Nihal786007/Apex/docs/Project_Roadmap.md

# APEX Project Roadmap

## Phase 1 ✅
- ESP32 Setup
- TB6612FNG Setup
- Motor Movement Test
- GitHub Repository

## Phase 2 🚧
- Professional Firmware Structure
- Bluetooth Control
- OLED Display
- Ultrasonic Sensor

## Phase 3
- Line Following
- Autonomous Navigation

## Phase 4
- AI Vision
- Voice Assistant

---

## Current evidence update — 27 October 2026

The phases above are the original roadmap and remain as historical context. V5 now implements manual Wi-Fi control, line following and bounded obstacle avoidance in software; its recorded build and tests are in [BUILD_REPORT.md](BUILD_REPORT.md). Supplied footage documents earlier manual-build work. Physical V5 line-following and autonomous-course acceptance remain pending. Bluetooth, vision and voice entries above are aspirations, not implemented-feature claims. The current [evidence-based roadmap](LIMITATIONS_AND_ROADMAP.md) governs new claims.
