Nihal786007/Apex/progress/Session_01_ESP32_First_Blink/Session_01_Notes.md

# Engineering Notes

## Date
16 July 2026

## Session
01

## Project
ESP32 First Blink

## Time Spent
(Write how many hours)

## Problems Faced

- Driver not detected initially.
- Windows showed Code 28.
- Installed CP210x driver manually.

## Solution

Installed the Silicon Labs CP210x driver and selected the correct COM port.

## Final Status

Project completed successfully.

## What I Learned Today

- How serial drivers work.
- How Arduino uploads code.
- How COM ports are assigned.
- How to troubleshoot ESP32 connection issues.

## Confidence Level

⭐⭐⭐⭐☆
