Nihal786007/Apex/assets/dashboard-line-preview.png

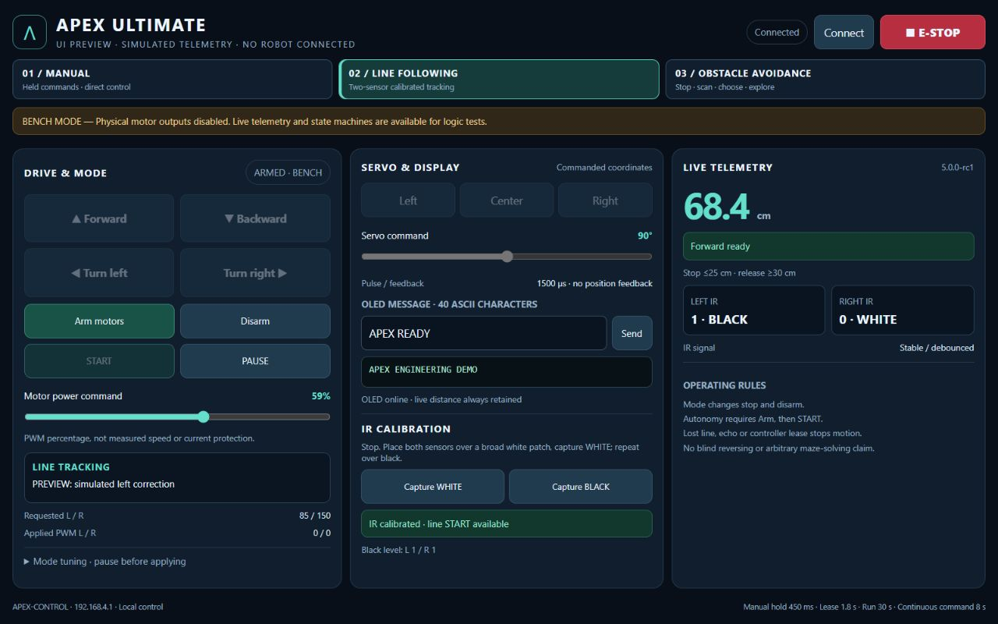
assets/dashboard-line-preview.png
