Nihal786007/Apex/assets/dashboard-phone-preview.png

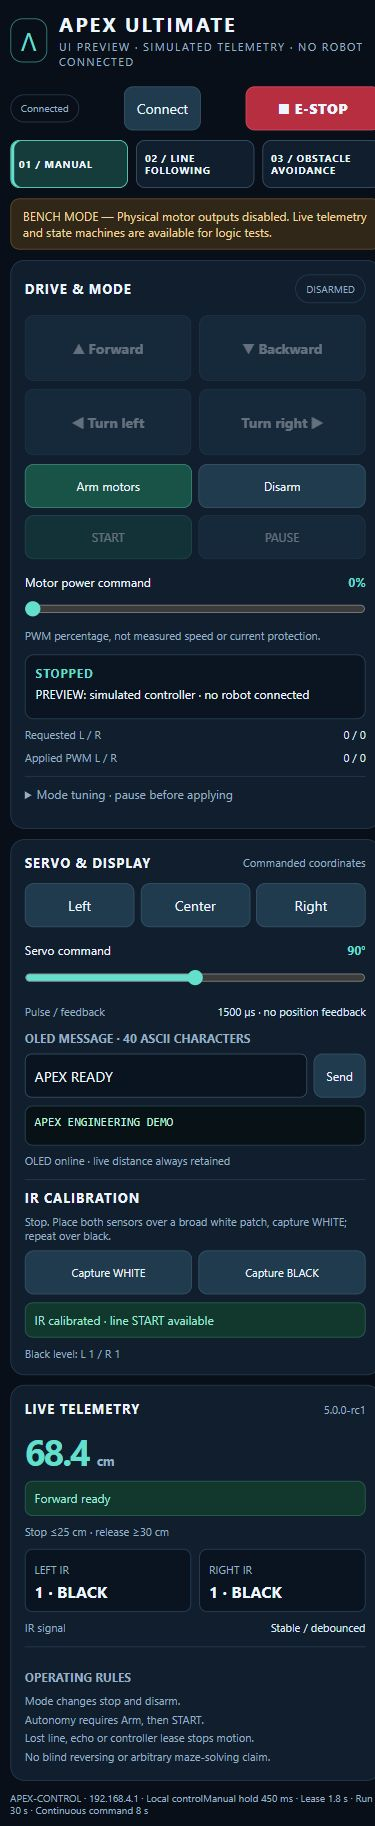
assets/dashboard-phone-preview.png
