Nihal786007/Apex/assets/photos/connecting ESP32.jpeg

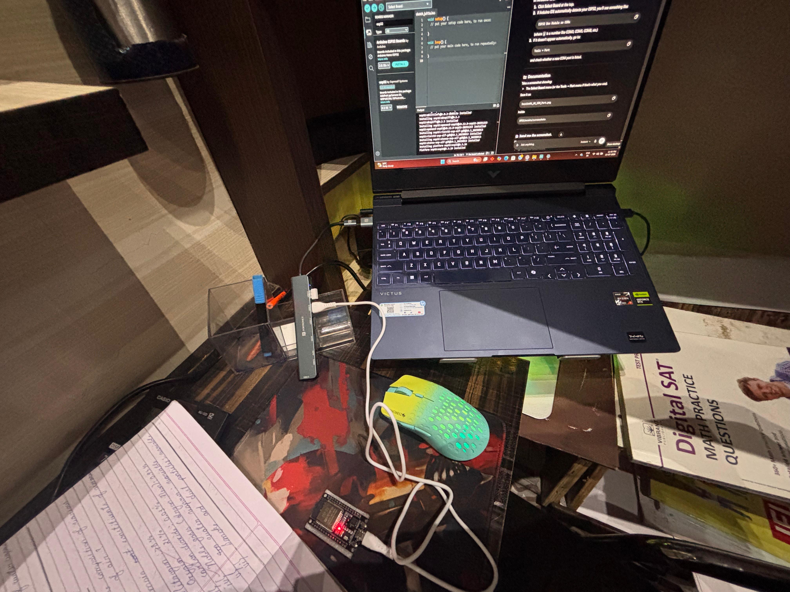
assets/photos/connecting ESP32.jpeg
