Nihal786007/Apex/assets/photos/esp32.jpeg

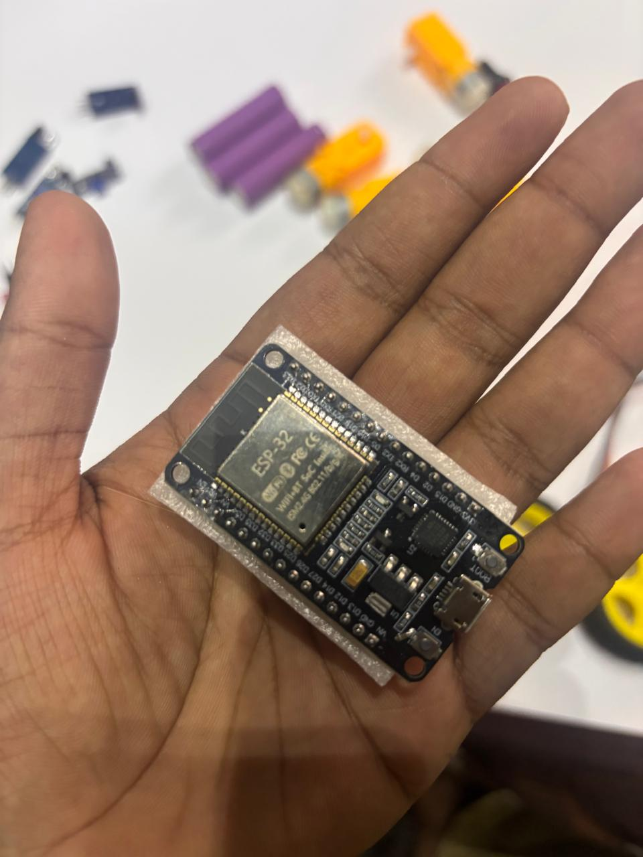
assets/photos/esp32.jpeg
