Nihal786007/Apex/assets/screenshots/connecting com .png

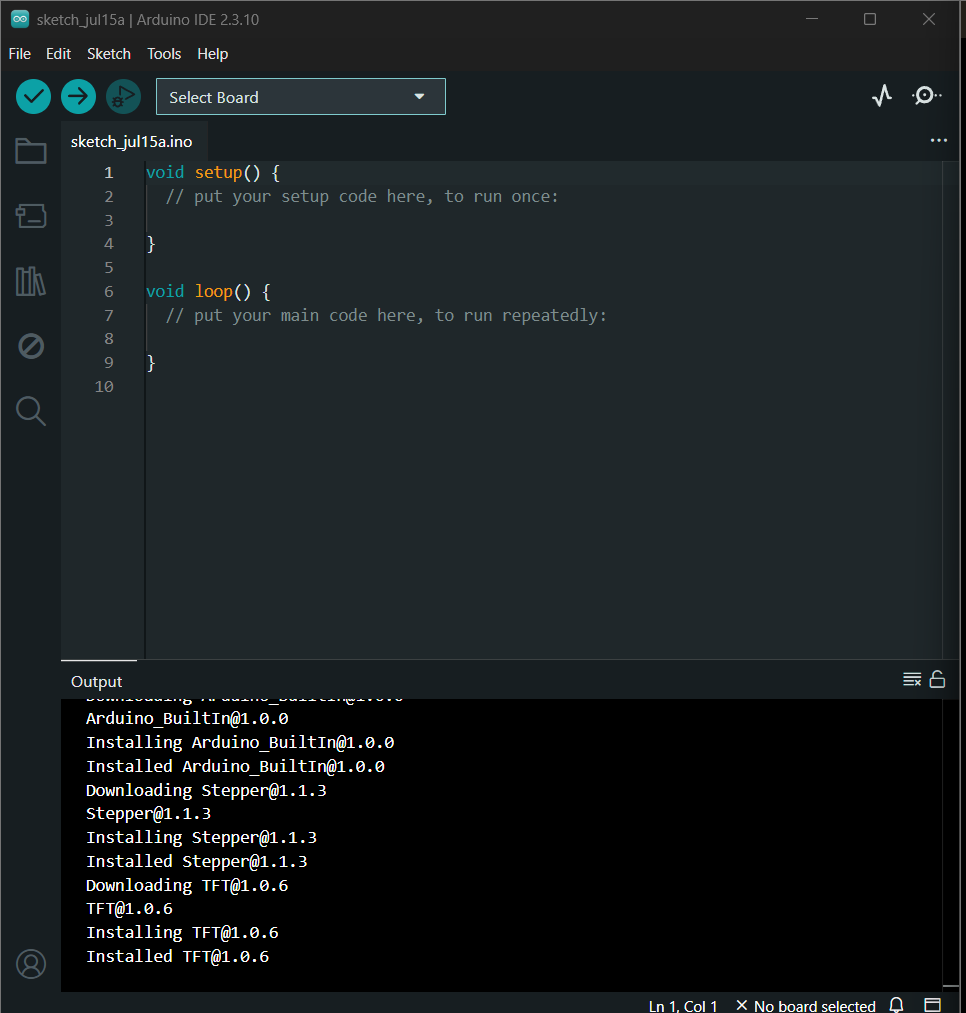
assets/screenshots/connecting com .png
