Nihal786007/Apex/assets/screenshots/python code for blinking esp32.png

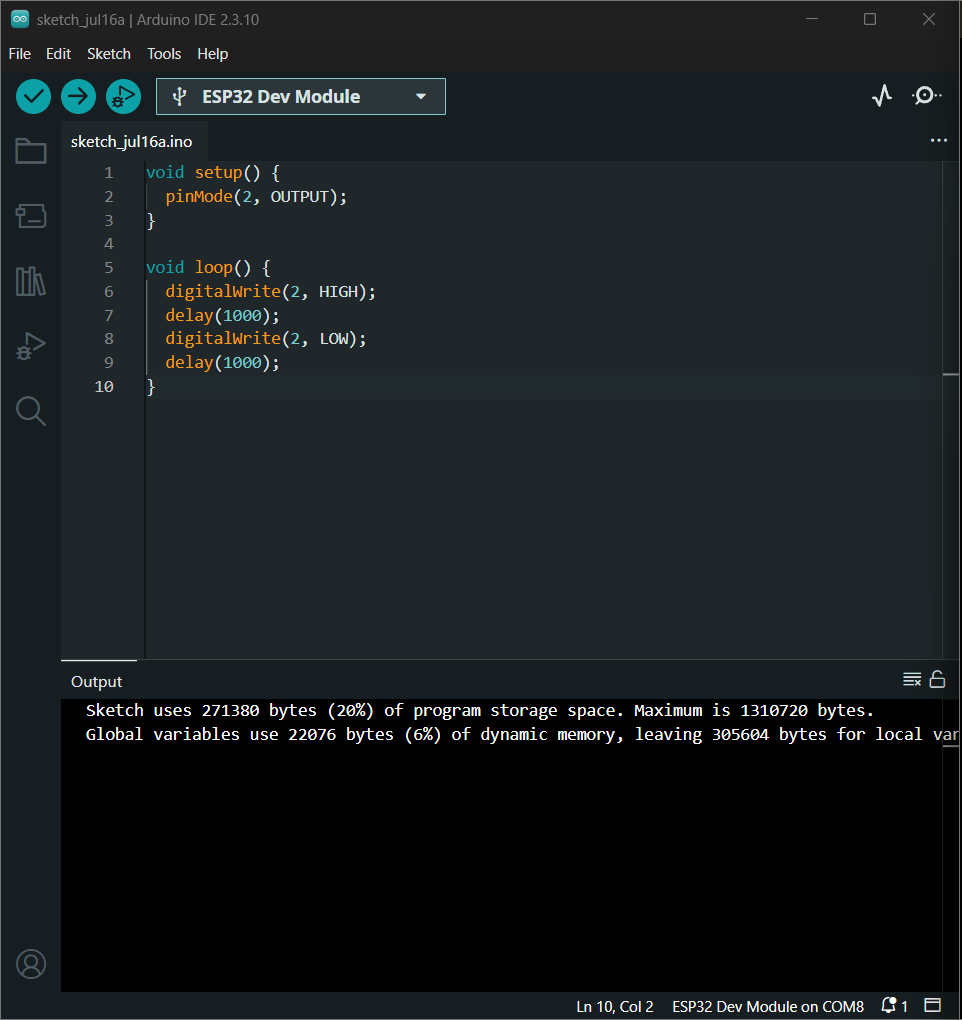
assets/screenshots/python code for blinking esp32.png
