Nihal786007/Apex/assets/screenshots/Screenshot (143).png

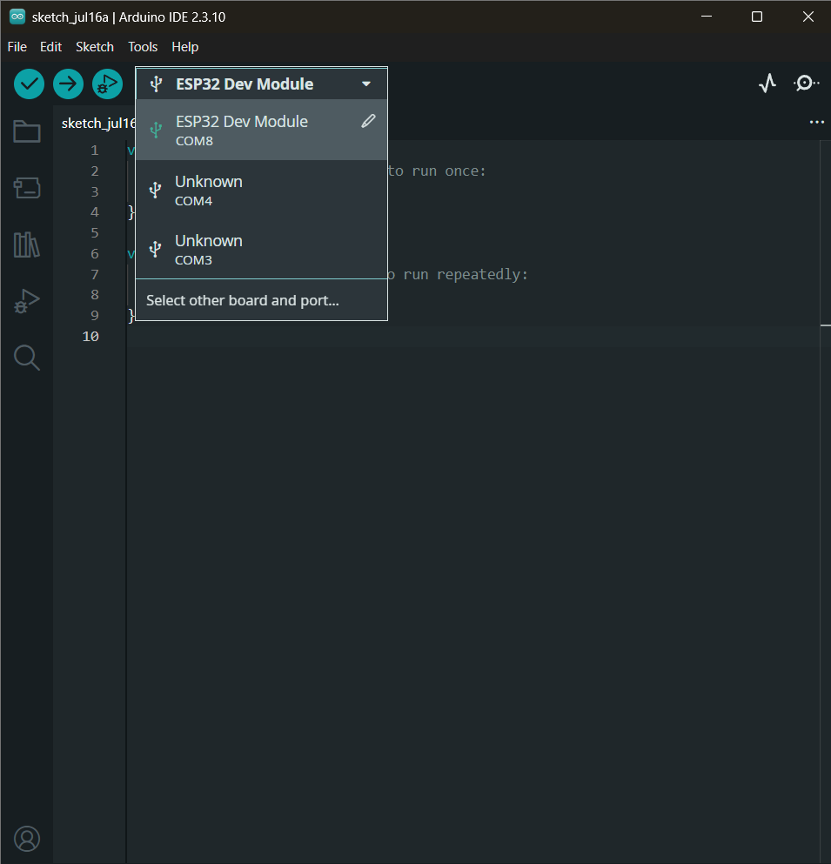
assets/screenshots/Screenshot (143).png
