Nihal786007/Apex/assets/screenshots/Session01_02_ESP32_Search.png

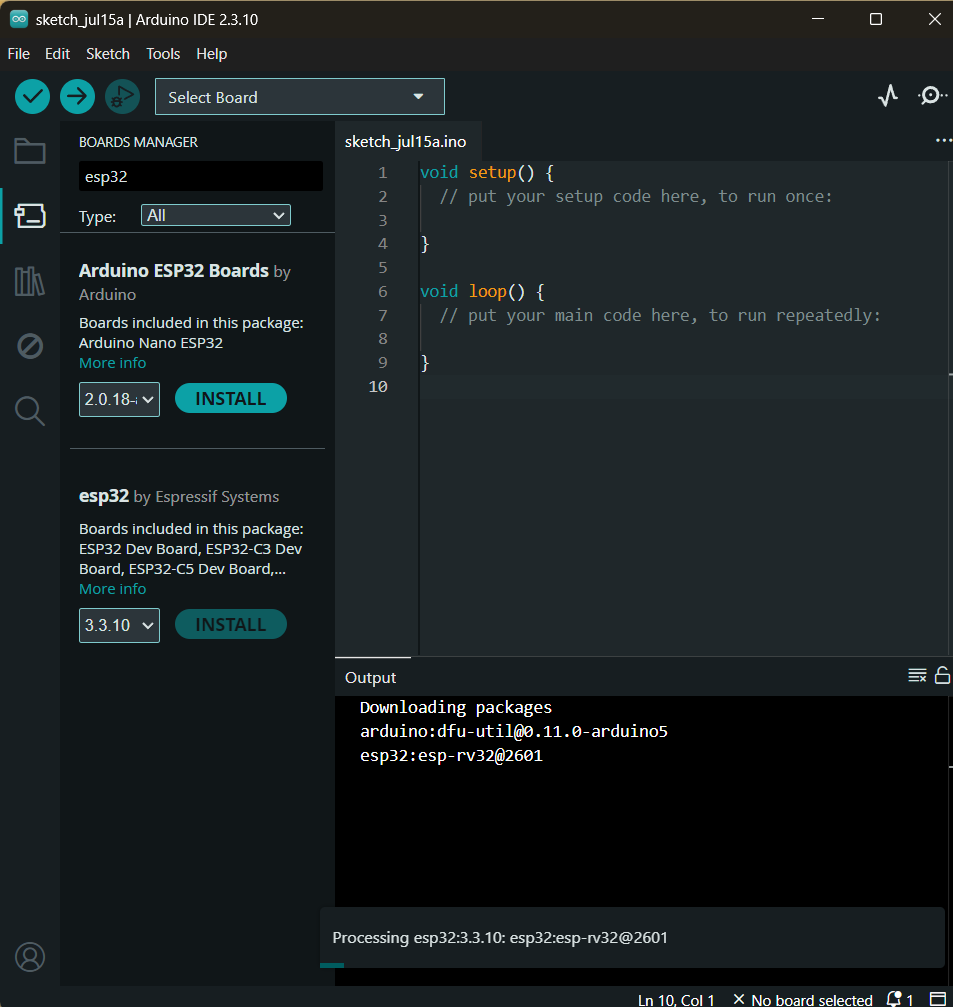
assets/screenshots/Session01_02_ESP32_Search.png
