Nihal786007/Apex/assets/screenshots/Session01_04_ESP32_Installed.png

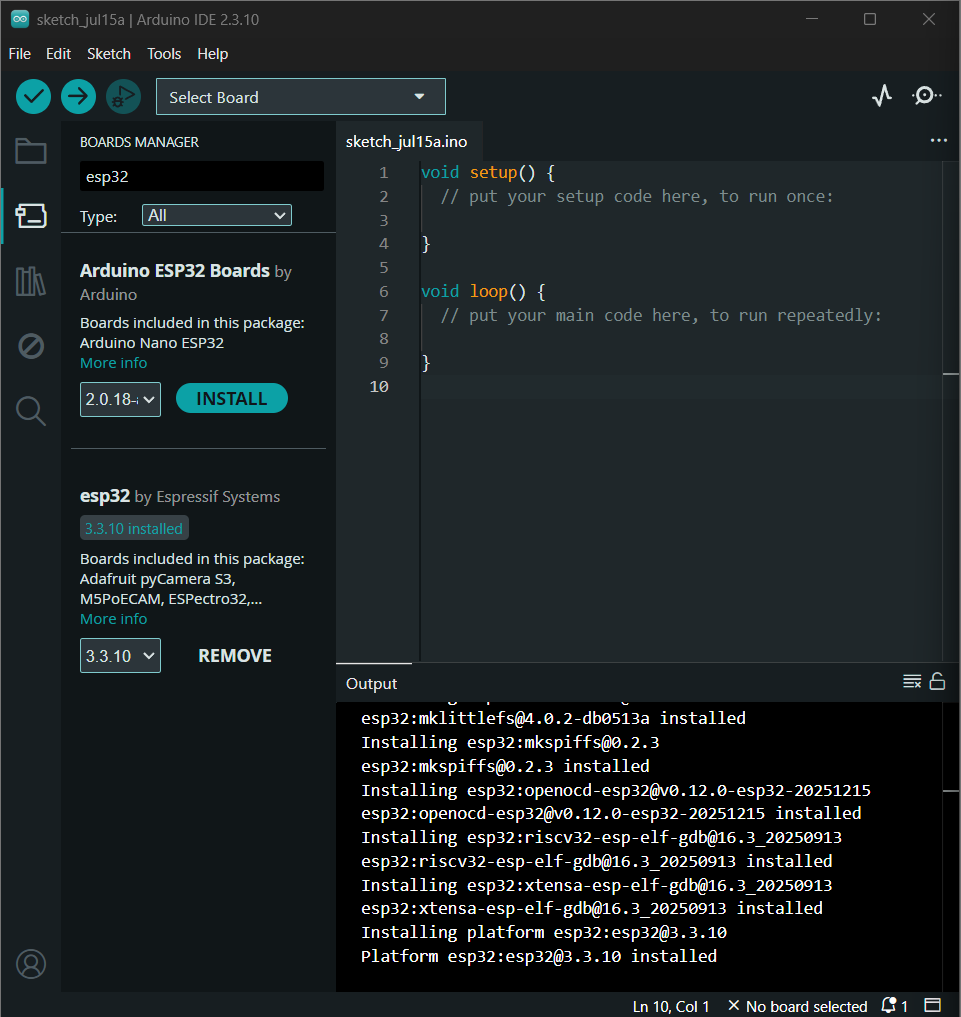
assets/screenshots/Session01_04_ESP32_Installed.png
