Nihal786007/Apex/CHANGELOG.md

# Changelog

All notable changes to the APEX project will be documented here.

---

## v0.1.0 - Initial Release

### Added

- Initial project structure
- ESP32 setup
- TB6612FNG motor driver integration
- Motor movement test
- GitHub repository setup
- Documentation structure

## 5.0.0-rc1 — 27 October 2026 — software candidate and engineering presentation

- Preserve the original commits, MIT license, early notes, Blink source and public media.
- Add the unchanged local V5 software candidate, reproducible tests, labeled UI previews and engineering guides.
- Introduce a selective five-image README with original-source provenance and explicit evidence status.
- Finalize the 80-second caption-led engineering film with original instrumental music and exact source provenance; keep its MP4 outside normal Git history. Physical autonomous acceptance remains pending.
- Keep the default motor output configuration in BENCH mode. No firmware behavior is changed by this presentation update.
